Aecert-Robotics/Hexapod/PCB/Hexapod PCB KiCad Project/Components/Voltage Regulator LM2596/dc-dc-lm2596-3a-step-down-converter-module-1.snapshot.5/HW-411_Top.jpg

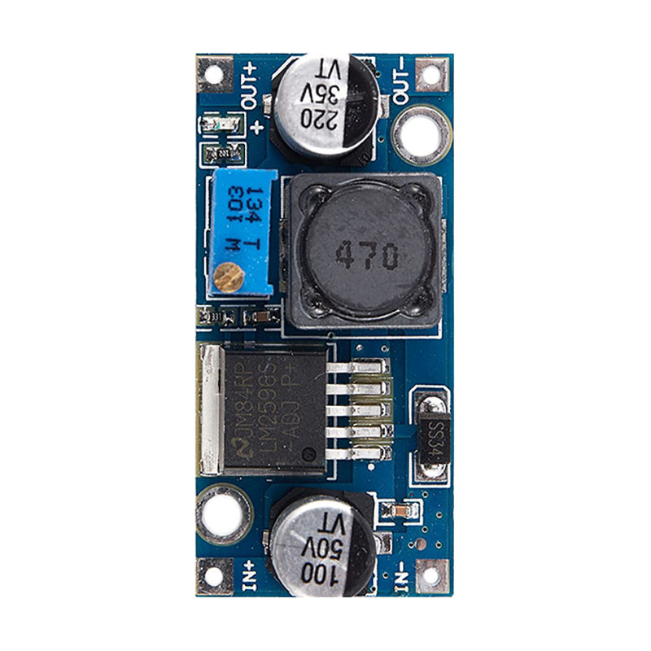
PCB/Hexapod PCB KiCad Project/Components/Voltage Regulator LM2596/dc-dc-lm2596-3a-step-down-converter-module-1.snapshot.5/HW-411_Top.jpg
