Aecert-Robotics/Hexapod/Pics/Color Scheme 5.png

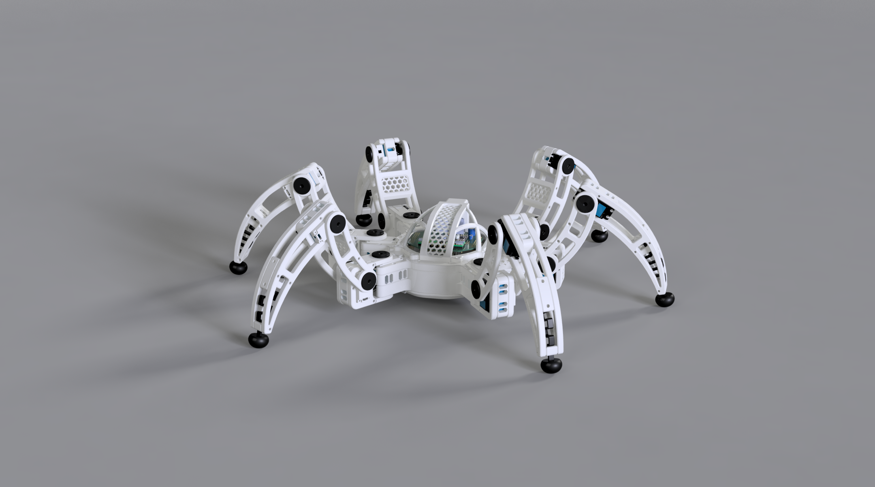
Pics/Color Scheme 5.png
