Aecert-Robotics/Hexapod/Pics/Color Scheme A.png

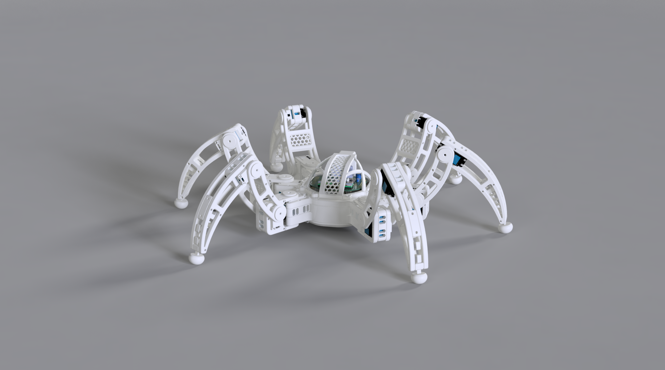
Pics/Color Scheme A.png
