Aecert-Robotics/Hexapod/PCB/Hexapod PCB KiCad Project/Components/nrf24l01/Renderings/nRF24L01+ CAD model 2.png

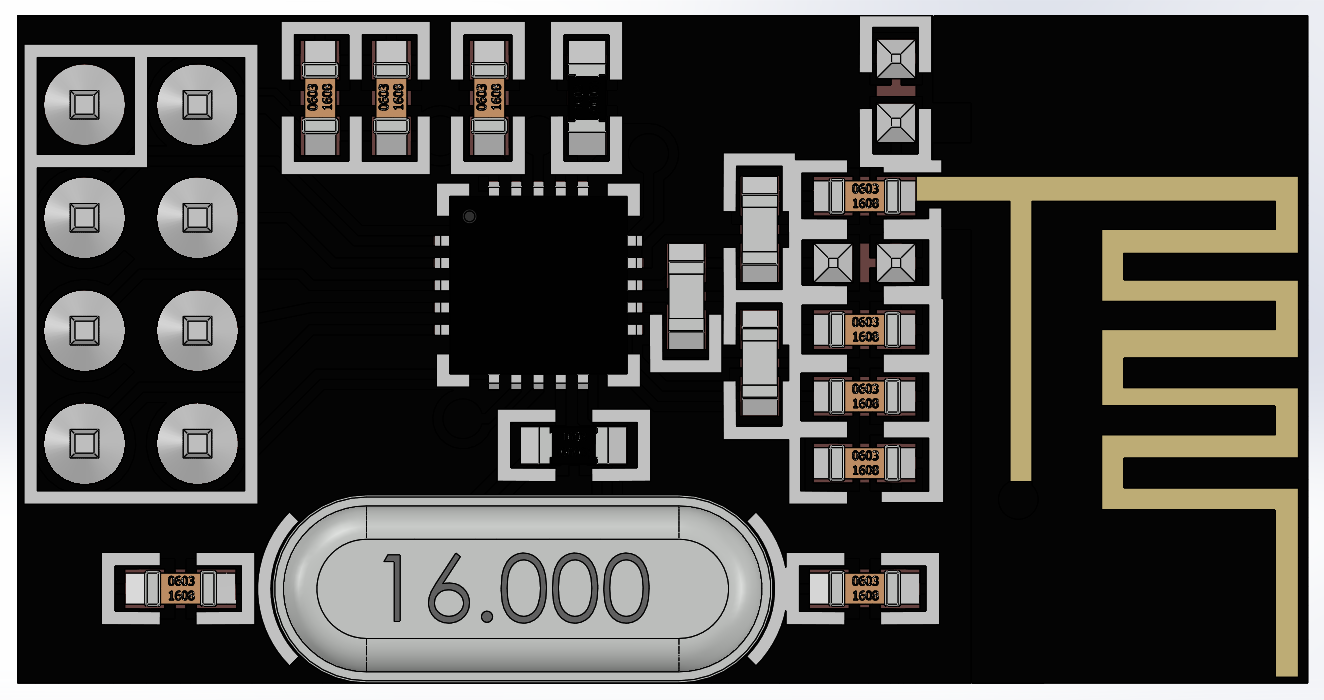
PCB/Hexapod PCB KiCad Project/Components/nrf24l01/Renderings/nRF24L01+ CAD model 2.png
