Aecert-Robotics/Hexapod/PCB/Hexapod PCB KiCad Project/Components/nrf24l01/Renderings/nRF24L01+ CAD model.png

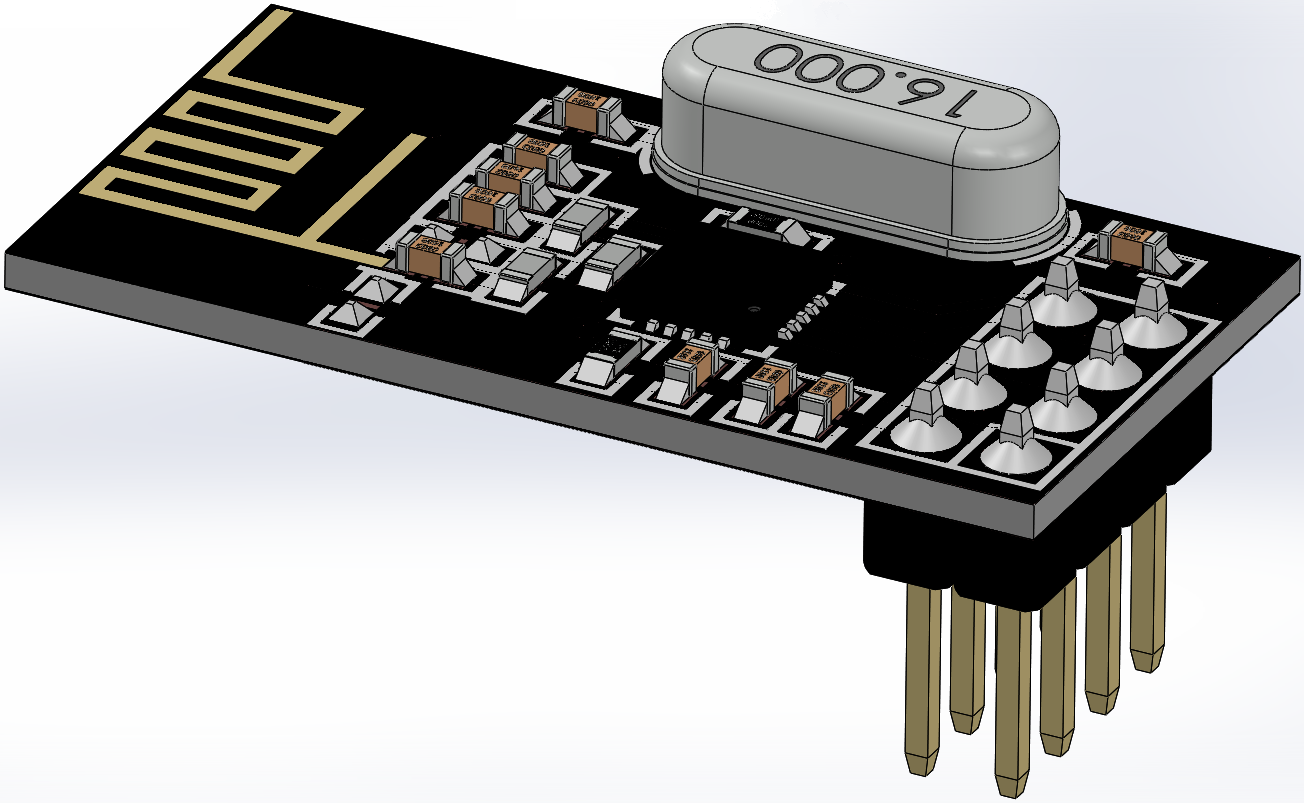
PCB/Hexapod PCB KiCad Project/Components/nrf24l01/Renderings/nRF24L01+ CAD model.png
