Aecert-Robotics/Hexapod/PCB/Hexapod PCB KiCad Project/Components/MPU6050 THT/MPU6050.stp

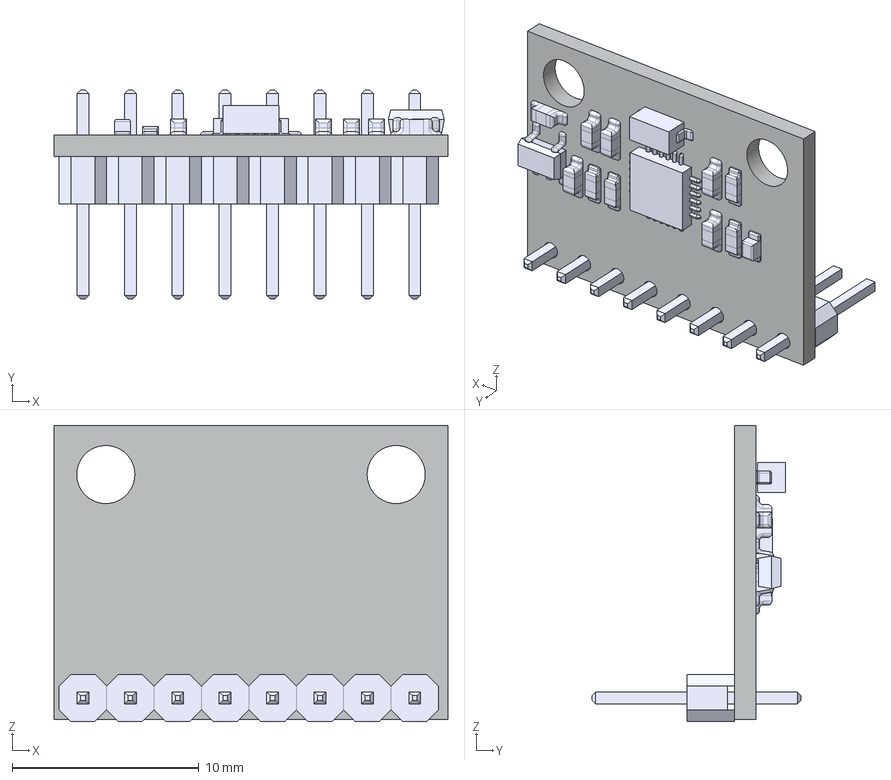
[picture p10: CAD file, 2025-02-21]
PCB/Hexapod PCB KiCad Project/Components/MPU6050 THT/MPU6050.stp
21.1 x 11.2 x 15.9 mm
