Aecert-Robotics/Hexapod/PCB/Hexapod PCB KiCad Project/Components/Terminal 2 Pin/TB005-762-02BE.step

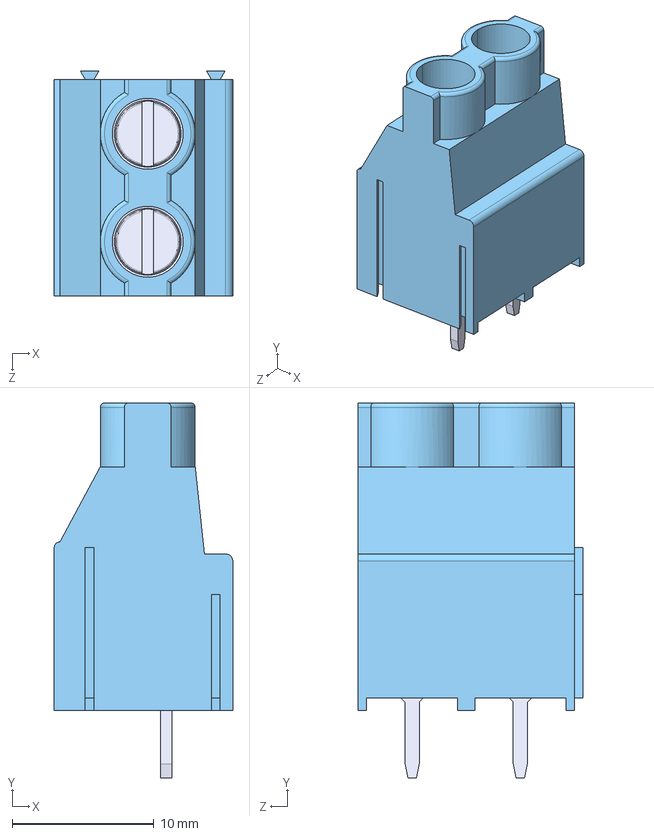
[picture p11: CAD file, 2025-02-17]
PCB/Hexapod PCB KiCad Project/Components/Terminal 2 Pin/TB005-762-02BE.step
12.6 x 26.5 x 15.8 mm
