Aecert-Robotics/Hexapod/STLs/Servo Case Blue Non Pro.stl

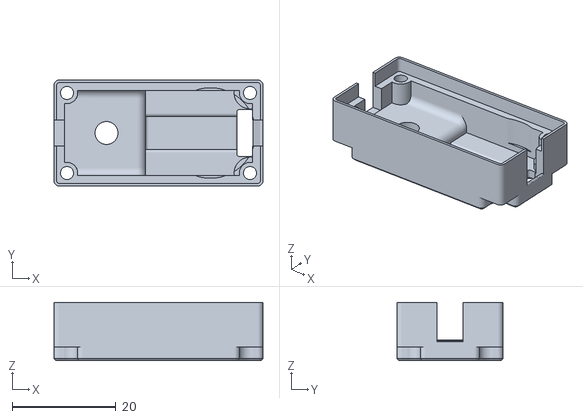
[picture p12: CAD file, 2025-04-15]
STLs/Servo Case Blue Non Pro.stl
40.2 x 20.4 x 11.2
