Aecert-Robotics/Hexapod/STLs/Everything.3mf

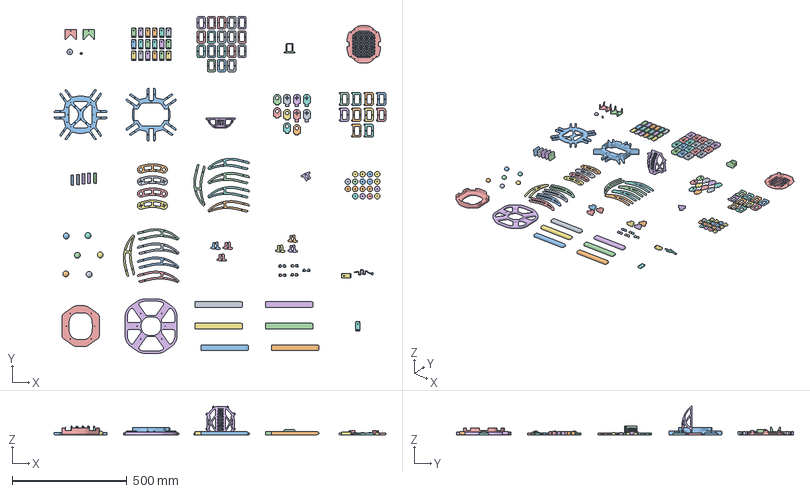
[picture p13: CAD file, 2025-04-09]
STLs/Everything.3mf
1445.1 x 1468.4 x 124.7 mm
Servo Case RED.stl x 19
Stand Leg.stl x 6
Tibia Bridge.stl x 7
Foot Shaft.stl
Tibia Left.stl x 5
Tibia Right.stl x 5
Femur Axle Side.stl x 2
Femur Bridge.stl x 5
Femur Horn Side.stl x 2
Coxa Left.stl x 5
Coxa Bottom.stl x 5
Coxa Right.stl x 5
Foot Left.stl x 5
PCB Spacer.stl
Foot Right.stl x 5
Coxa Top.stl x 5
Servo Case Axle.stl x 19
Frame Center.stl
Battery Clip.stl x 2
Servo Mount.stl x 18
Frame Top.stl
Power Switch Holder.stl
Frame Bottom.stl
Roll Cage TEST 3.stl
Foot Toe.stl x 6
Stand Top.stl
Stand Base.stl
Servo Case BLUE.stl
