Aecert-Robotics/Hexapod/STLs/Servo Case BLUE.stl

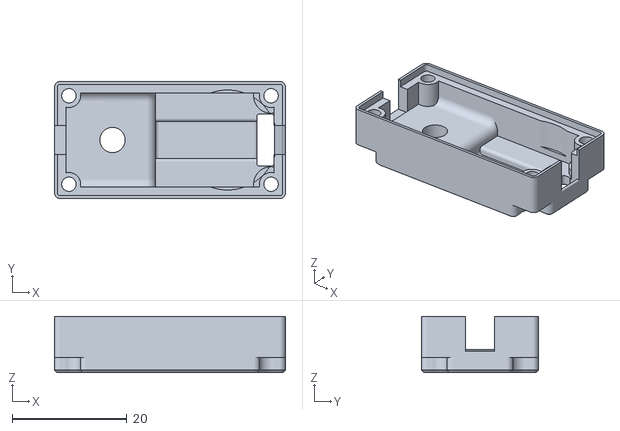
[picture p14: CAD file, 2025-04-09]
STLs/Servo Case BLUE.stl
40.2 x 20.4 x 9.75
