Aecert-Robotics/Hexapod/STLs/Battery.stl

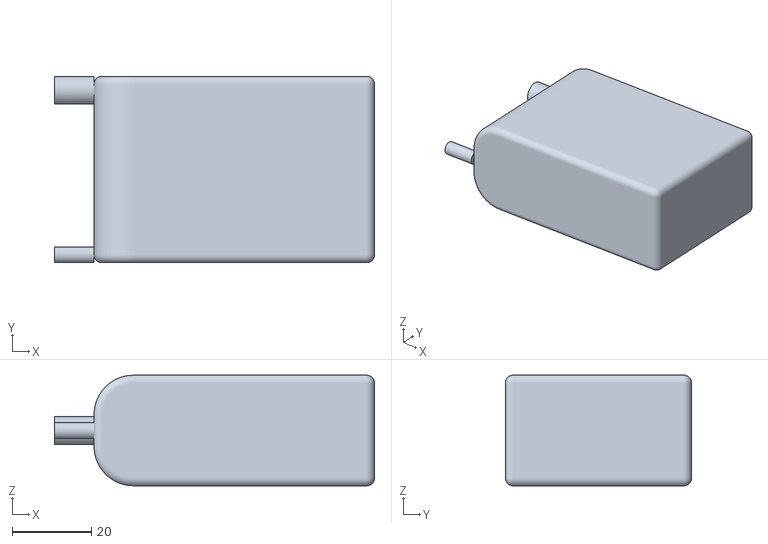
[picture p15: CAD file, 2025-03-29]
STLs/Battery.stl
81.0 x 47.2 x 28.0
