Aecert-Robotics/Hexapod/STLs/Stand Top.stl

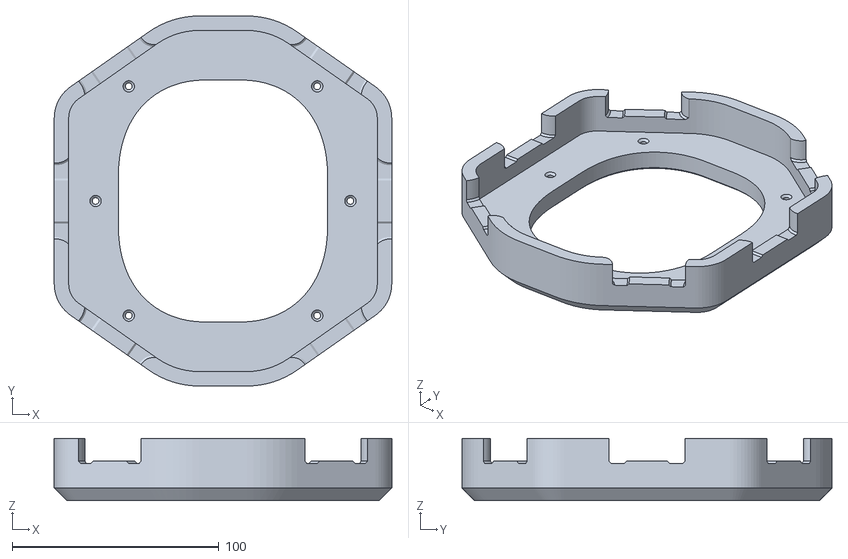
[picture p16: CAD file, 2025-03-29]
STLs/Stand Top.stl
163.3 x 179.0 x 30.0
