Aecert-Robotics/Hexapod/STLs/Stand Leg.stl

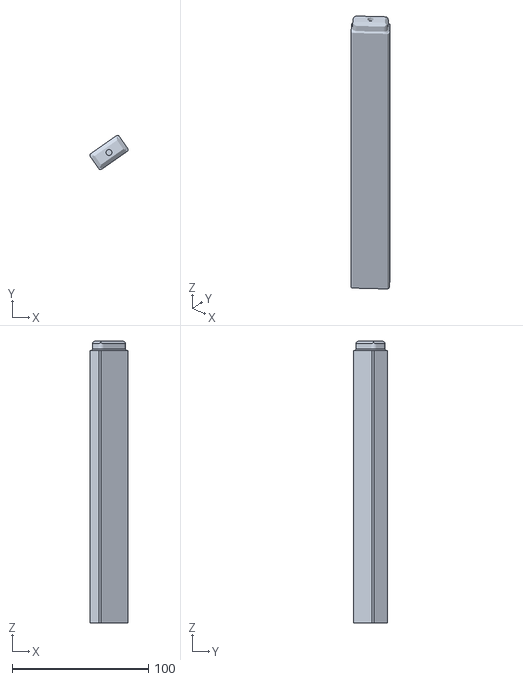
[picture p17: CAD file, 2025-03-29]
STLs/Stand Leg.stl
28.2 x 25.2 x 207.0
