Aecert-Robotics/Hexapod/STLs/Stand Base.stl

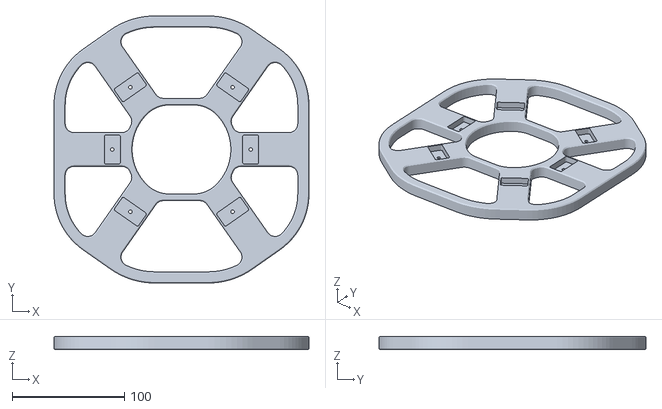
[picture p18: CAD file, 2025-03-29]
STLs/Stand Base.stl
227.3 x 238.0 x 12.0
