Aecert-Robotics/Hexapod/STLs/Coxa Bottom.stl

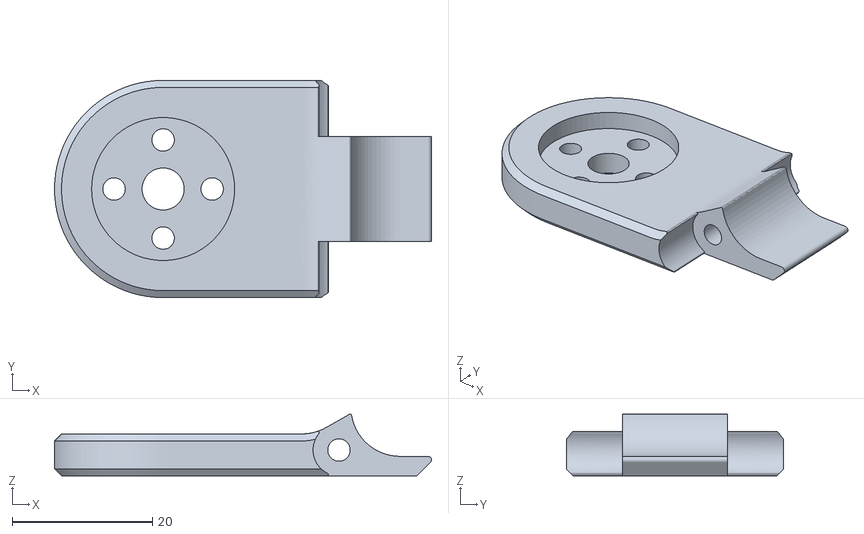
[picture p19: CAD file, 2025-03-27]
STLs/Coxa Bottom.stl
53.8 x 31.0 x 8.84
