Aecert-Robotics/Hexapod/STLs/Coxa Left.stl

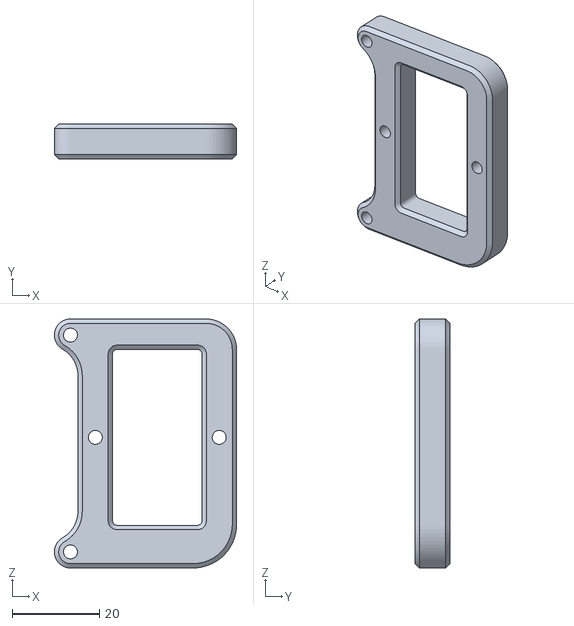
[picture p20: CAD file, 2025-03-27]
STLs/Coxa Left.stl
41.8 x 8.00 x 57.1
