Aecert-Robotics/Hexapod/STLs/Coxa Top.stl

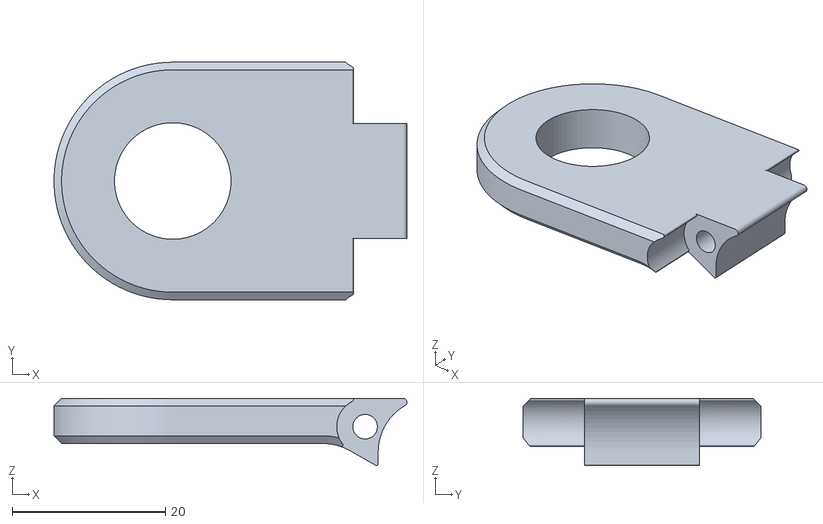
[picture p21: CAD file, 2025-03-27]
STLs/Coxa Top.stl
46.0 x 31.0 x 8.79
