Aecert-Robotics/Hexapod/STLs/Foot Shaft.stl

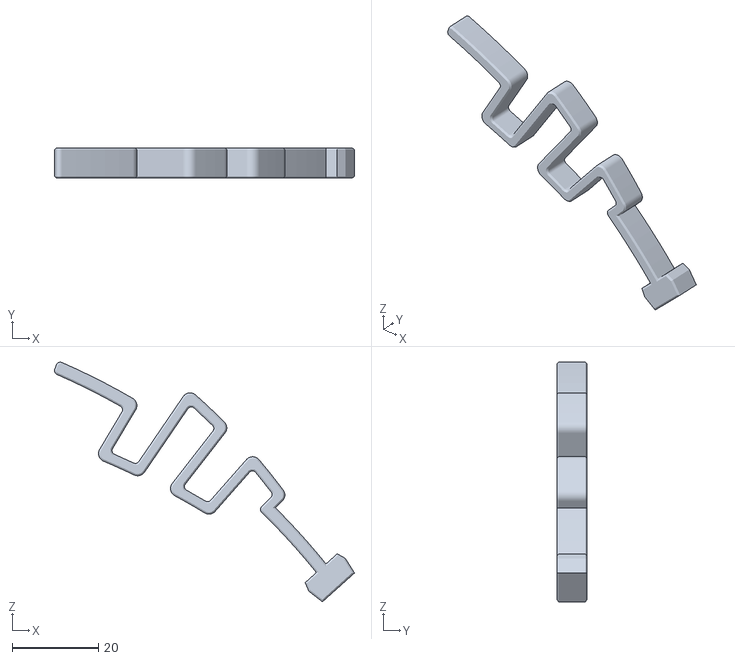
[picture p22: CAD file, 2025-03-27]
STLs/Foot Shaft.stl
69.6 x 7.00 x 55.6
