Aecert-Robotics/Hexapod/STLs/Tibia Bridge.stl

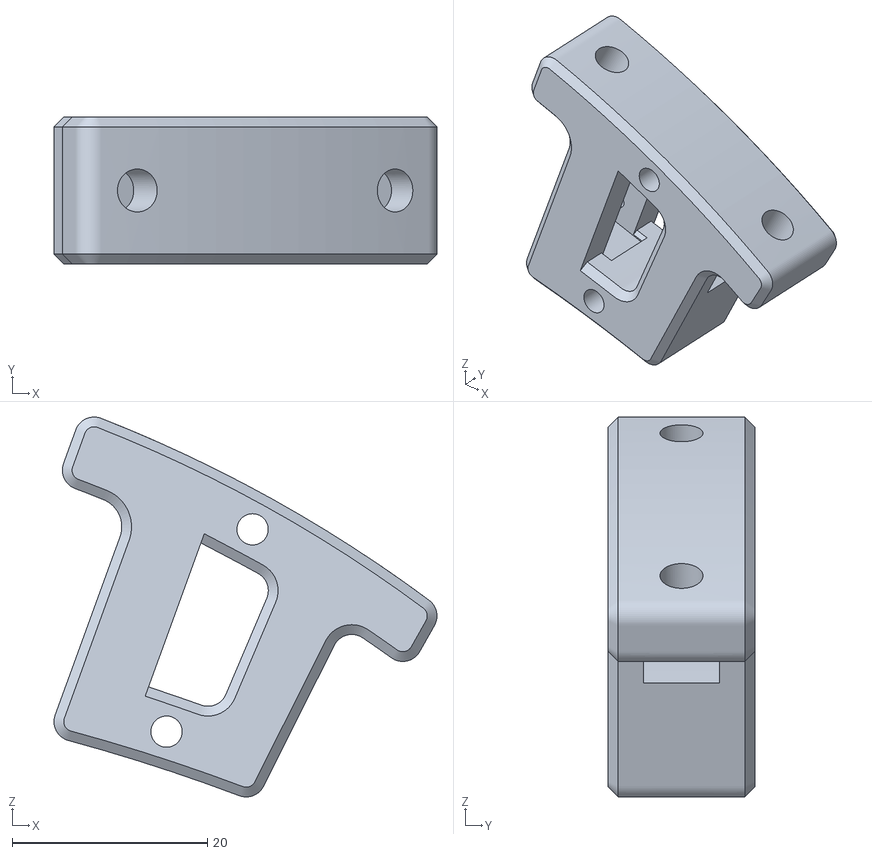
[picture p23: CAD file, 2025-03-27]
STLs/Tibia Bridge.stl
39.2 x 15.0 x 38.9
