Aecert-Robotics/Hexapod/STLs/Femur Horn Side.stl

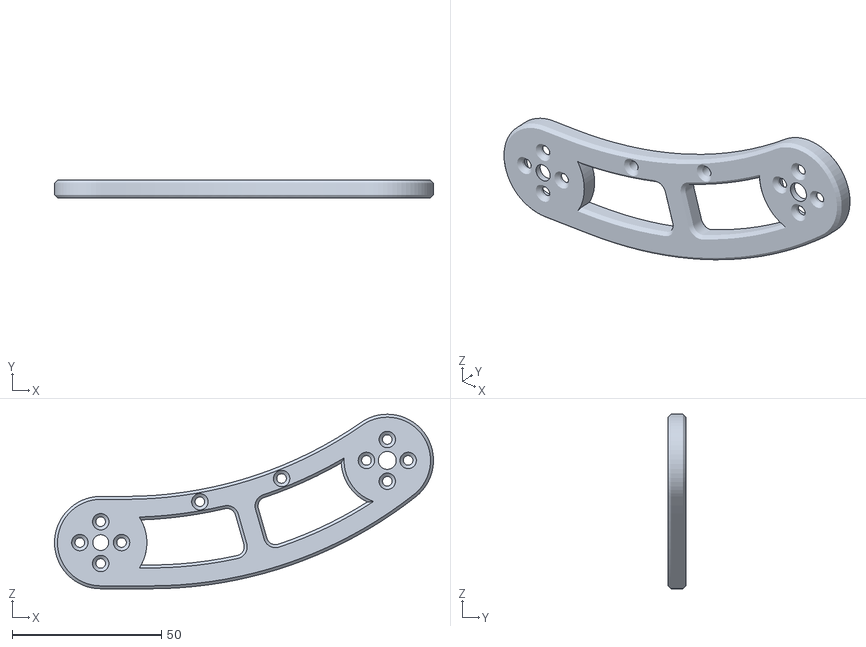
[picture p24: CAD file, 2025-03-27]
STLs/Femur Horn Side.stl
127.1 x 6.00 x 58.6
