Aecert-Robotics/Hexapod/STLs/Femur Axle Side.stl

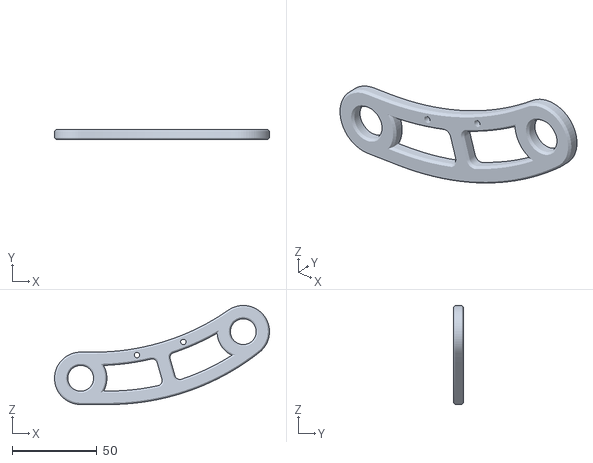
[picture p25: CAD file, 2025-03-27]
STLs/Femur Axle Side.stl
127.1 x 6.00 x 58.6
