Aecert-Robotics/Hexapod/STLs/Tibia Left.stl

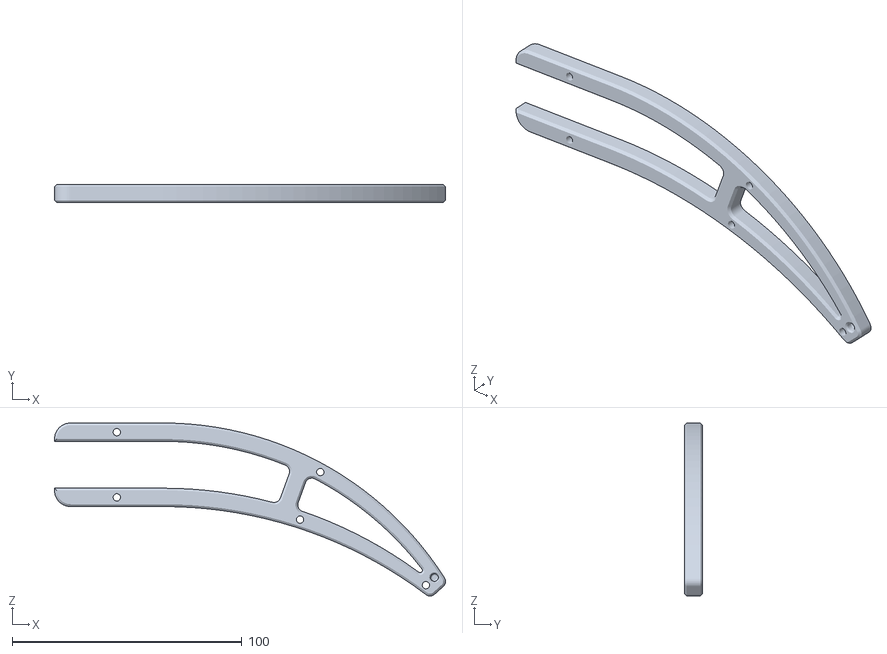
[picture p26: CAD file, 2025-03-27]
STLs/Tibia Left.stl
170.3 x 8.00 x 75.4
