Aecert-Robotics/Hexapod/STLs/Foot Right.stl

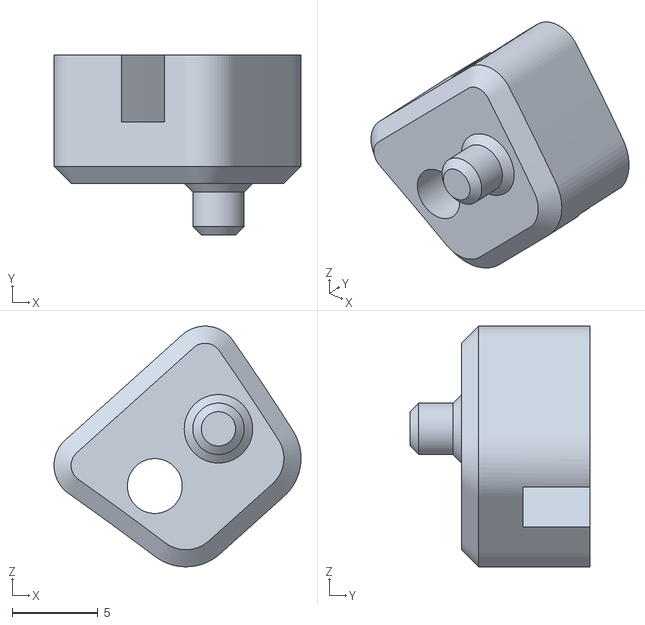
[picture p27: CAD file, 2025-03-27]
STLs/Foot Right.stl
14.4 x 10.5 x 14.1
