Aecert-Robotics/Hexapod/STLs/Femur Bridge.stl

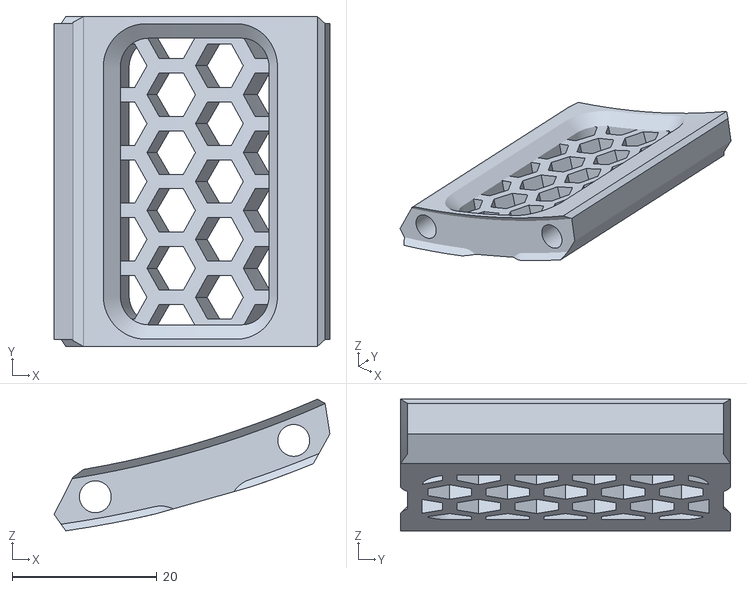
[picture p28: CAD file, 2025-03-27]
STLs/Femur Bridge.stl
38.1 x 45.6 x 18.2
