Aecert-Robotics/Hexapod/STLs/Roll Cage.stl

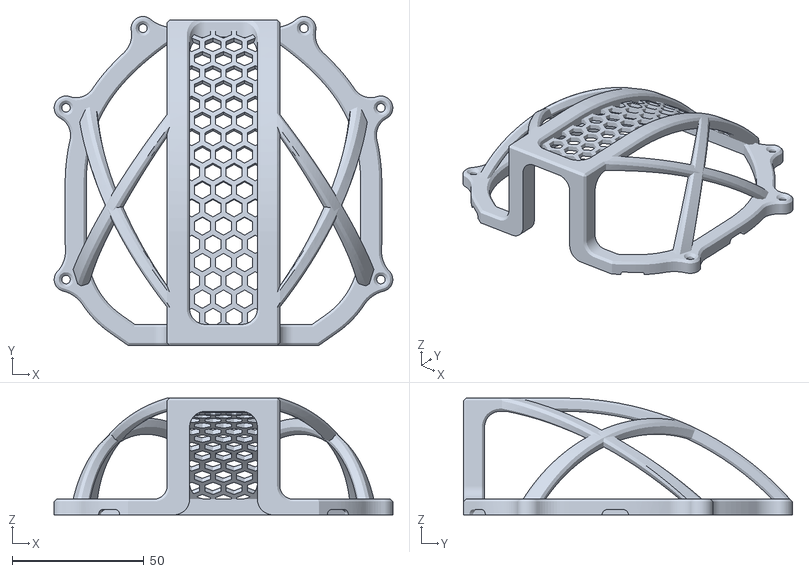
[picture p29: CAD file, 2025-03-26]
STLs/Roll Cage.stl
128.3 x 124.7 x 44.2
