Aecert-Robotics/Hexapod/STLs/Servo Case Axle.stl

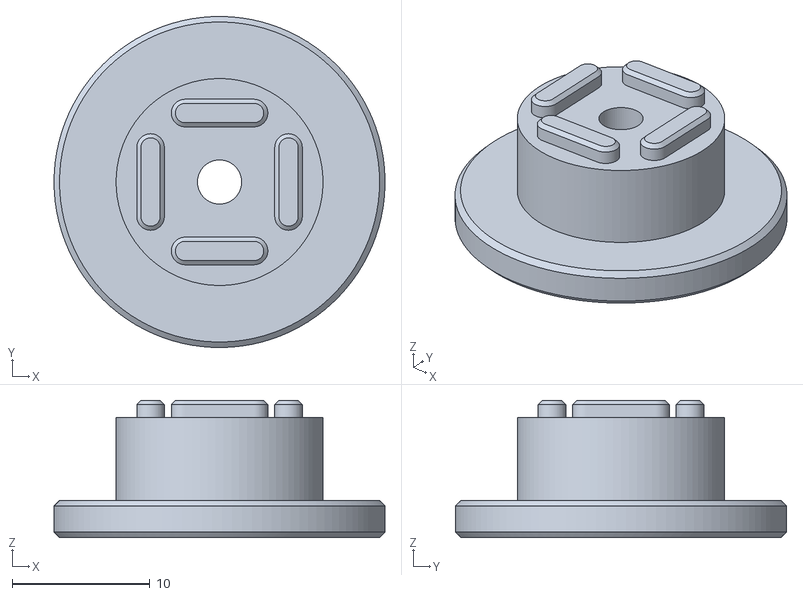
[picture p30: CAD file, 2025-03-26]
STLs/Servo Case Axle.stl
24.0 x 24.0 x 9.95
