Aecert-Robotics/Hexapod/STLs/Femur Cap.stl

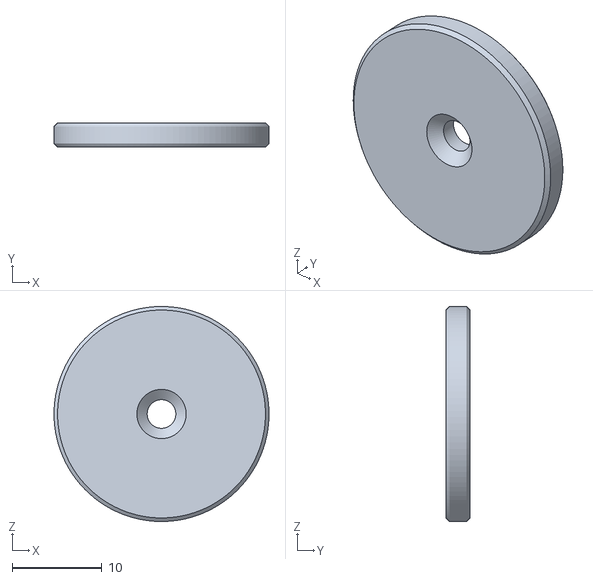
[picture p31: CAD file, 2025-03-26]
STLs/Femur Cap.stl
24.0 x 2.70 x 24.0
