Aecert-Robotics/Hexapod/STLs/Servo Mount.stl

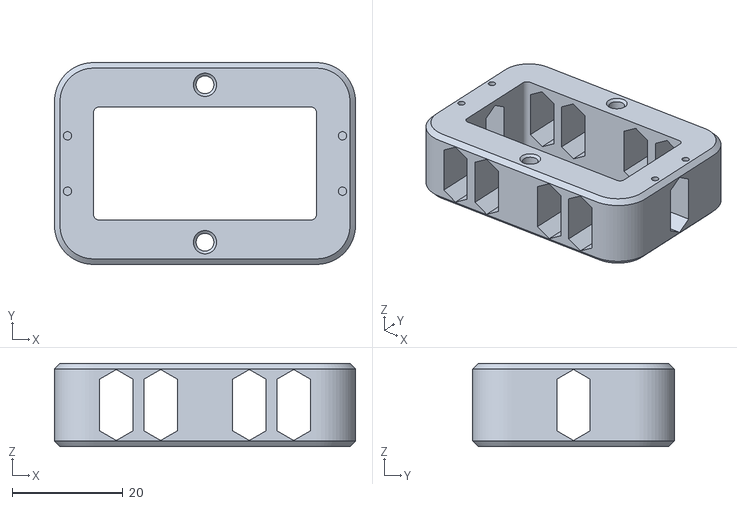
[picture p32: CAD file, 2025-03-26]
STLs/Servo Mount.stl
54.3 x 36.4 x 15.0
