Aecert-Robotics/Hexapod/STLs/Frame Center.stl

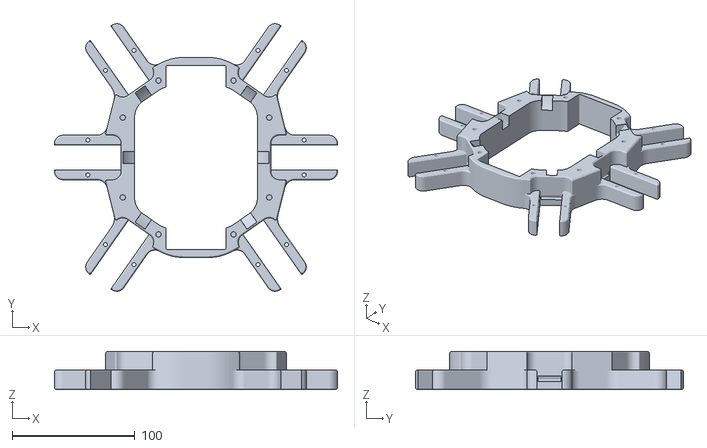
[picture p33: CAD file, 2025-03-19]
STLs/Frame Center.stl
230.6 x 218.1 x 31.0
