Aecert-Robotics/Hexapod/STLs/Battery Clip.stl

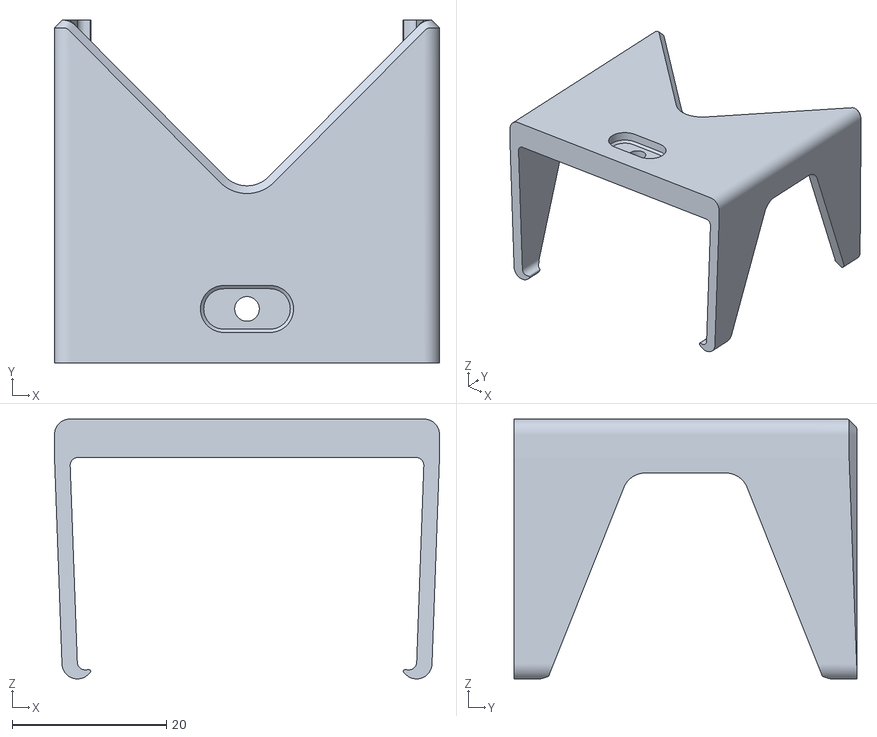
[picture p34: CAD file, 2025-03-19]
STLs/Battery Clip.stl
50.0 x 44.5 x 33.7
