Aecert-Robotics/Hexapod/STLs/Frame Bottom.stl

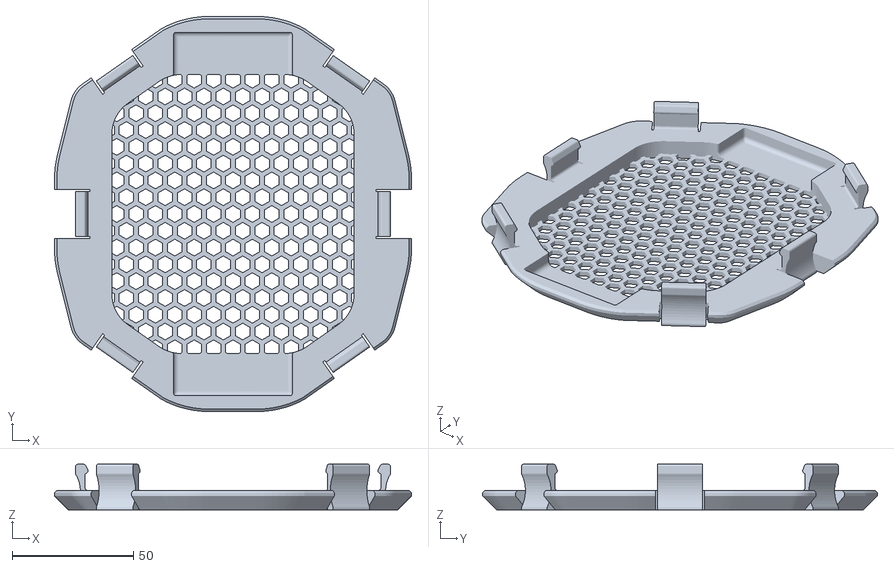
[picture p35: CAD file, 2025-03-19]
STLs/Frame Bottom.stl
147.4 x 163.0 x 18.8
