Aecert-Robotics/Hexapod/STLs/Power Switch Holder.stl

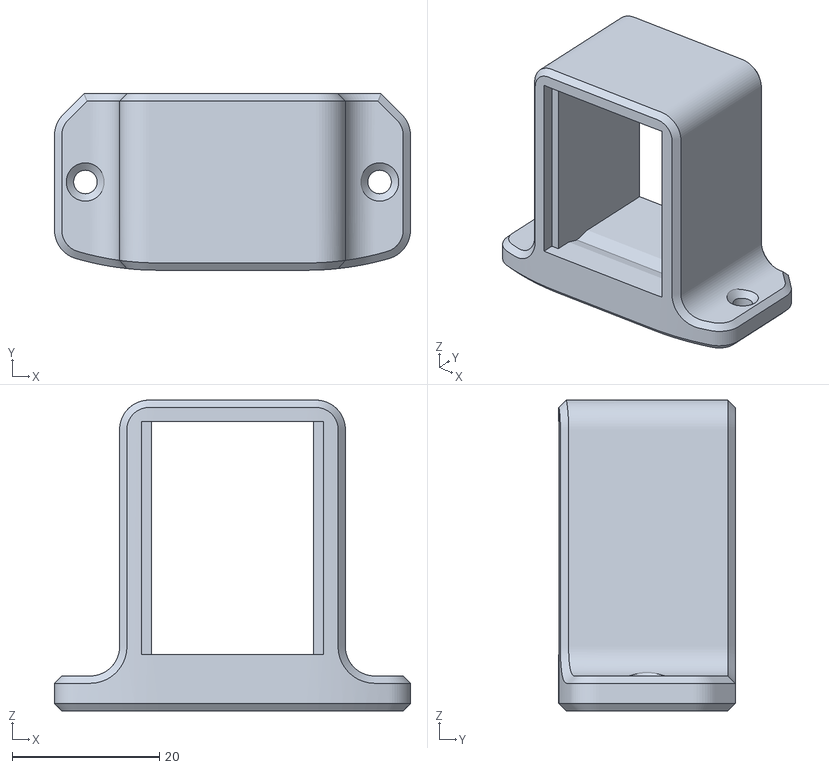
[picture p36: CAD file, 2025-03-18]
STLs/Power Switch Holder.stl
48.4 x 24.0 x 42.2
