Aecert-Robotics/Hexapod/STLs/Frame Top.stl

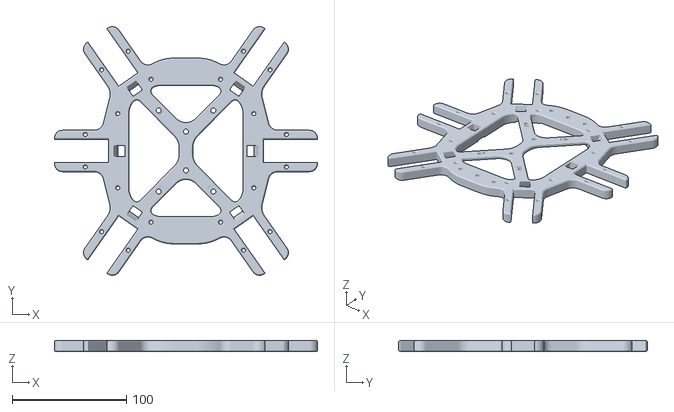
[picture p37: CAD file, 2025-03-18]
STLs/Frame Top.stl
230.6 x 218.1 x 10.0
