Aecert-Robotics/Hexapod/STLs/Foot Toe.stl

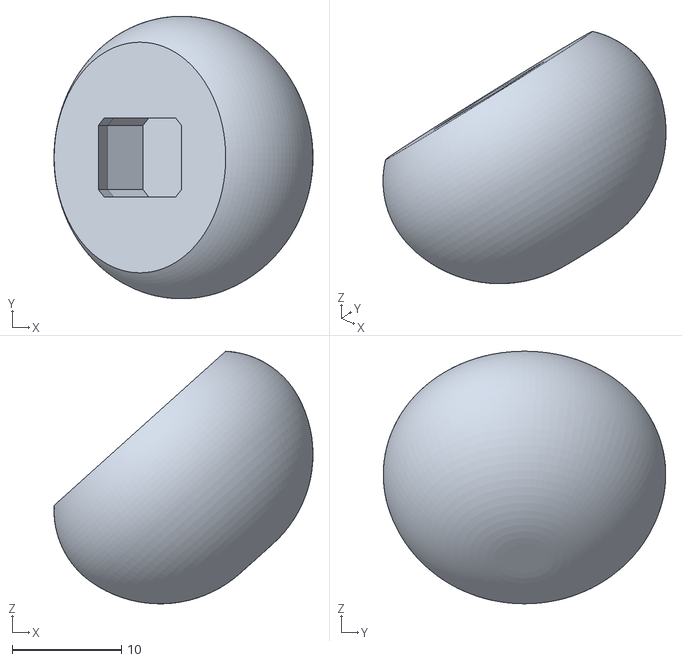
[picture p38: CAD file, 2025-03-11]
STLs/Foot Toe.stl
23.7 x 25.8 x 23.1
