Aecert-Robotics/Hexapod/STLs/Servo Case RED.stl

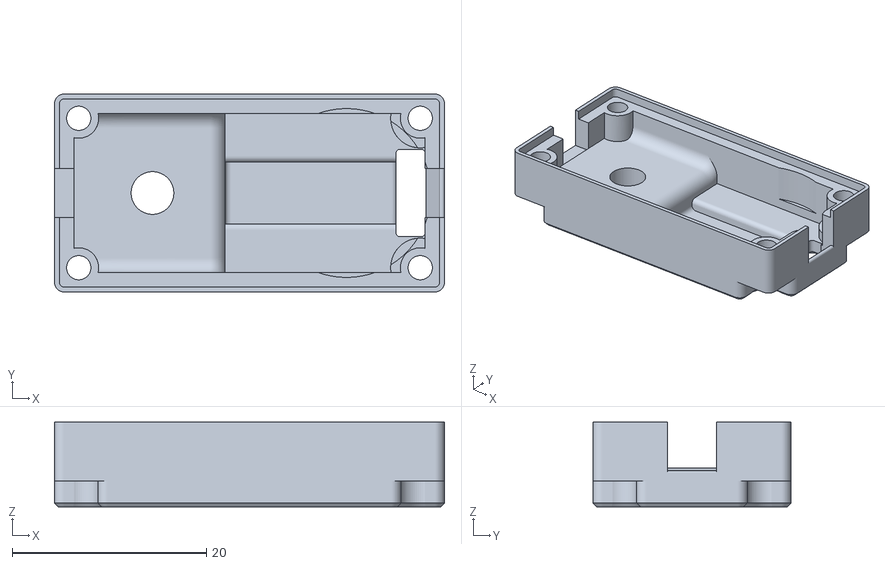
[picture p39: CAD file, 2025-03-08]
STLs/Servo Case RED.stl
40.2 x 20.4 x 8.75
