Aecert-Robotics/Hexapod/STLs/Servo Case.stl

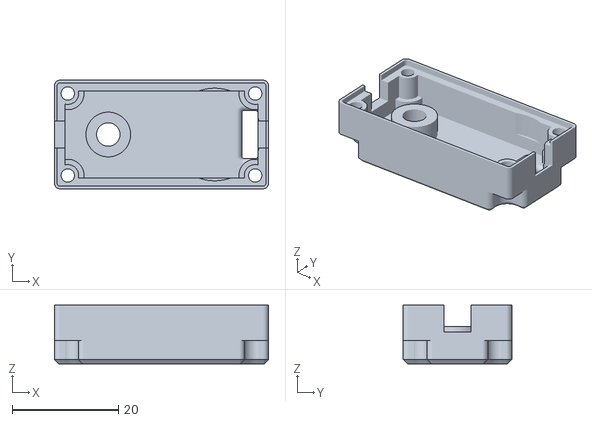
[picture p40: CAD file, 2025-03-05]
STLs/Servo Case.stl
40.2 x 20.4 x 11.0
