Aecert-Robotics/Hexapod/STLs/PCB Spacer.stl

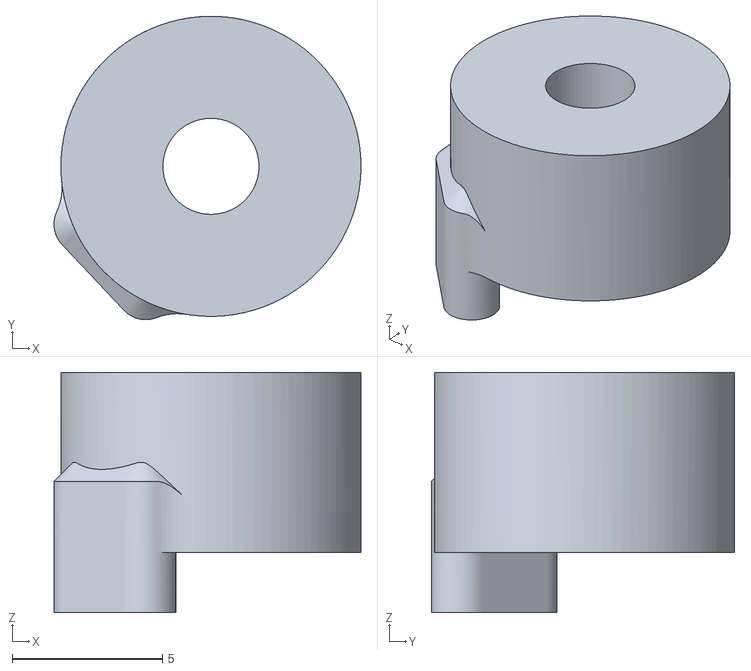
[picture p41: CAD file, 2025-03-04]
STLs/PCB Spacer.stl
10.2 x 10.1 x 8.00
