Aecert-Robotics/Hexapod/(list of files, cad)

Other CAD files:
STLs/Coxa Right.stl
STLs/Tibia Right.stl
STLs/Foot Left.stl
