Aecert-Robotics/Hexapod/Pics/Assembled (Fast).png

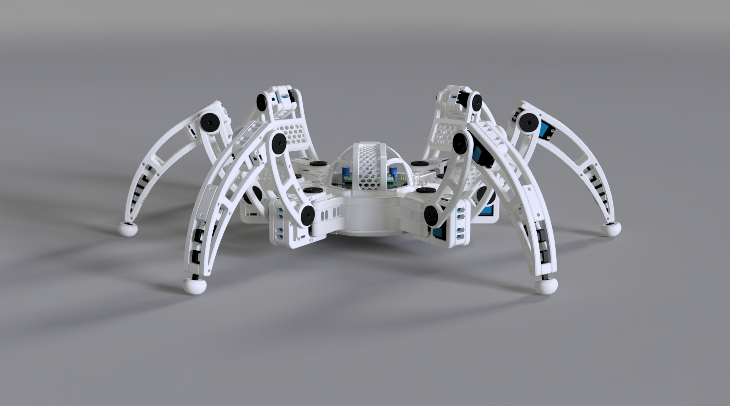
Pics/Assembled (Fast).png
