Aecert-Robotics/Hexapod/Pics/Assembled.png

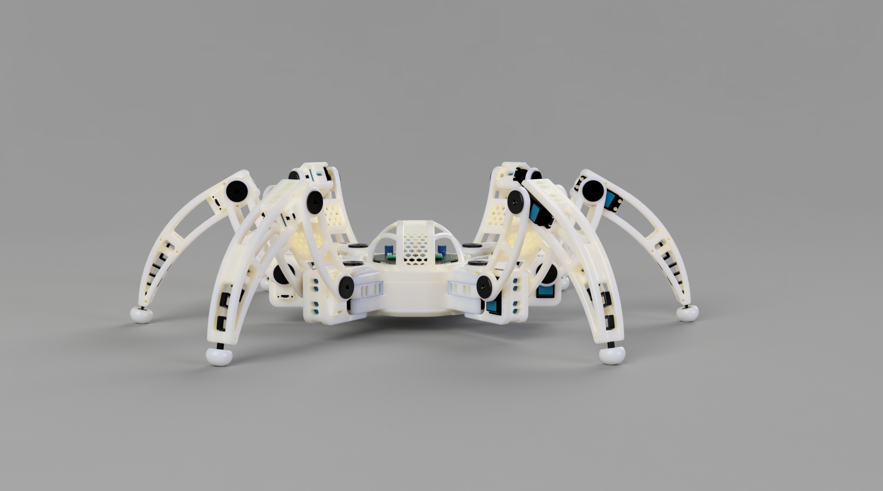
Pics/Assembled.png
