Aecert-Robotics/Hexapod/Pics/STEP.png

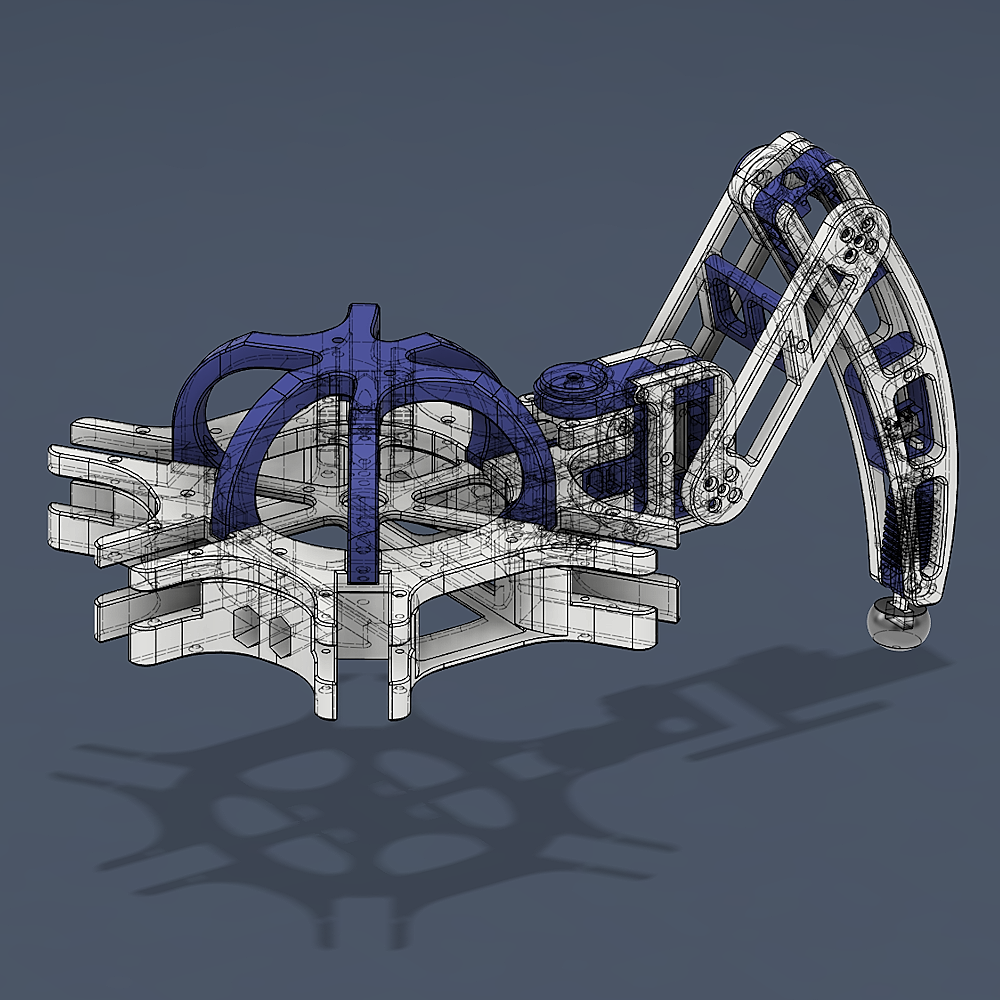
Pics/STEP.png
