Aecert-Robotics/Hexapod/PCB/Hexapod PCB KiCad Project/Hexapod PCB KiCad Project.kicad_pcb

## KiCad design PCB/Hexapod PCB KiCad Project/Hexapod PCB KiCad Project.kicad_pcb (2025-03-22)

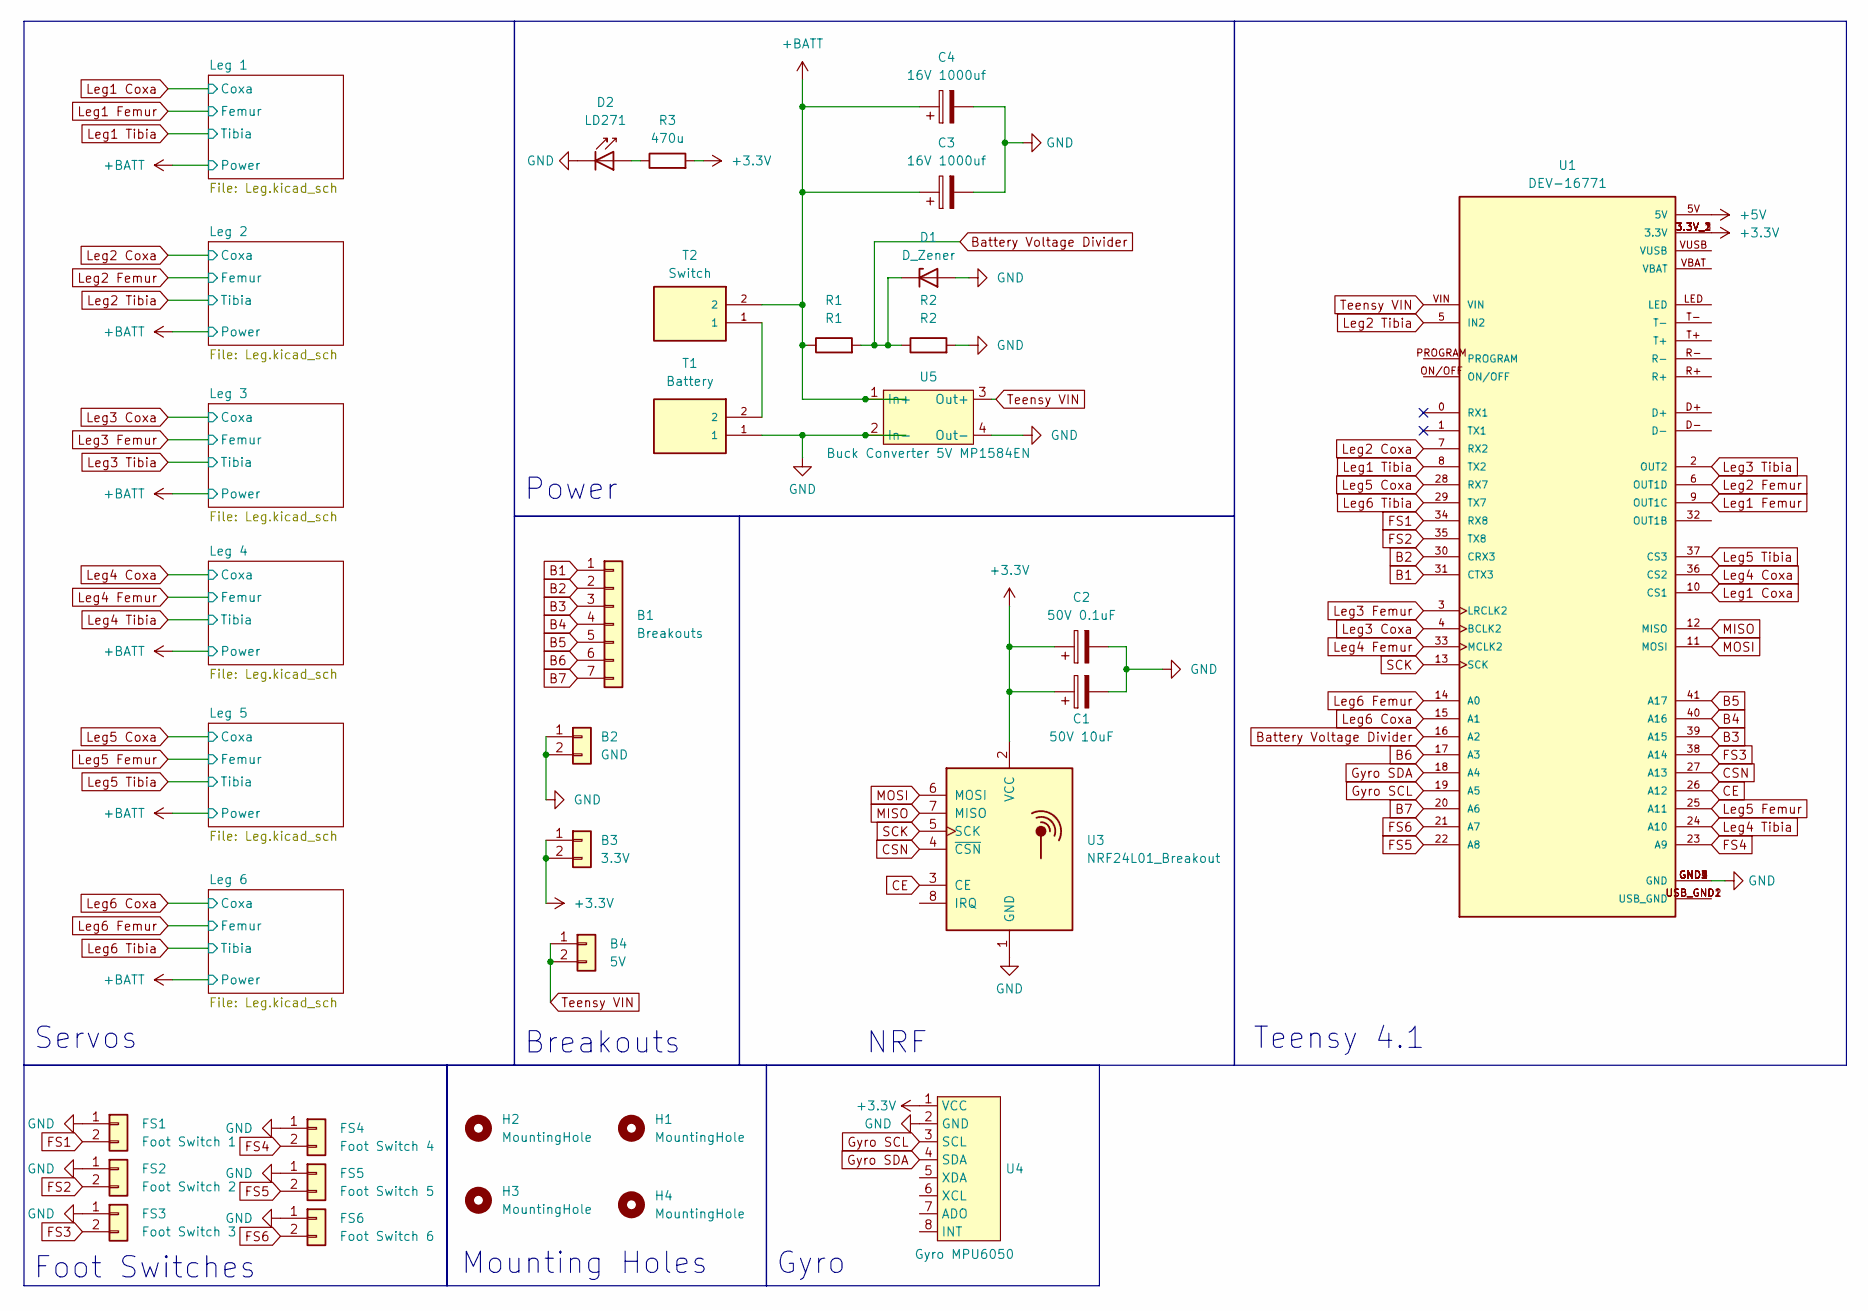
[picture p46: schematic Hexapod PCB KiCad Project.kicad_sch, Hexapod PCB - Teensy 4.1]

Parts:
B1: Breakouts; PinSocket_1x07_P2.54mm_Vertical
B2: GND; PinSocket_1x02_P2.54mm_Vertical
B3: 3.3V; PinSocket_1x02_P2.54mm_Vertical
B4: 5V; PinSocket_1x02_P2.54mm_Vertical
C1: 50V 10uF; CP_Radial_D5.0mm_P2.00mm
C2: 50V 0.1uF; CP_Radial_D4.0mm_P2.00mm
C3, C4: 16V 1000uf; CP_Radial_D10.0mm_P5.00mm
D1: D_Zener; D_T-1_P5.08mm_Horizontal
D2: LD271; LED_D5.0mm_IRGrey
FS1: Foot Switch 1; PinHeader_1x02_P2.54mm_Vertical
FS2: Foot Switch 2; PinHeader_1x02_P2.54mm_Vertical
FS3: Foot Switch 3; PinHeader_1x02_P2.54mm_Vertical
FS4: Foot Switch 4; PinHeader_1x02_P2.54mm_Vertical
FS5: Foot Switch 5; PinHeader_1x02_P2.54mm_Vertical
FS6: Foot Switch 6; PinHeader_1x02_P2.54mm_Vertical
H1, H2, H3, H4: MountingHole; MountingHole_3.2mm_M3
R1: R1; R_Axial_DIN0207_L6.3mm_D2.5mm_P7.62mm_Horizontal
R2: R2; R_Axial_DIN0207_L6.3mm_D2.5mm_P7.62mm_Horizontal
R3: 470u; R_Axial_DIN0207_L6.3mm_D2.5mm_P7.62mm_Horizontal
T1: Battery; CUI_TB005-762-02BE
T2: Switch; CUI_TB005-762-02BE
U1: DEV-16771; MODULE_DEV-16771; PARTREV 4.1
U3: NRF24L01_Breakout; nRF24L01_Breakout
U4: Gyro MPU6050; MPU6050 THT
U5: Buck Converter 5V MP1584EN

Connections:
+3.3V: B3.1, B3.2, C1.1, C2.1, R3.2, U1.3.3V_1 (3.3V), U1.3.3V_2 (3.3V), U1.3.3V_3 (3.3V), U3.2 (VCC), U4.1 (VCC)
+5V: U1.5V
+BATT: C3.1, C4.1, R1.1, T2.2, U5.1 (In+); also elsewhere on the board
B1: B1.1, U1.31 (CTX3)
B2: B1.2, U1.30 (CRX3)
B3: B1.3, U1.39 (A15)
B4: B1.4, U1.40 (A16)
B5: B1.5, U1.41 (A17)
B6: B1.6, U1.17 (A3)
B7: B1.7, U1.20 (A6)
Battery Voltage Divider: D1.1 (K), R1.2, R2.1, U1.16 (A2)
CE: U1.26 (A12), U3.3 (CE)
CSN: U1.27 (A13), U3.4 (~CSN)
FS1: FS1.2, U1.34 (RX8)
FS2: FS2.2, U1.35 (TX8)
FS3: FS3.2, U1.38 (A14)
FS4: FS4.2, U1.23 (A9)
FS5: FS5.2, U1.22 (A8)
FS6: FS6.2, U1.21 (A7)
GND: B2.1, B2.2, C1.2, C2.2, C3.2, C4.2, D1.2 (A), D2.1 (K), FS1.1, FS2.1, FS3.1, FS4.1, FS5.1, FS6.1, R2.2, T1.1, U1.GND1 (GND), U1.GND2 (GND), U1.GND3 (GND), U1.GND4 (GND), U1.GND5 (GND), U3.1 (GND), U4.2 (GND), U5.2 (In-), U5.4 (Out-); also elsewhere on the board
Gyro SCL: U1.19 (A5), U4.3 (SCL)
Gyro SDA: U1.18 (A4), U4.4 (SDA)
Leg1 Coxa: U1.10 (CS1); also elsewhere on the board
Leg1 Femur: U1.9 (OUT1C); also elsewhere on the board
Leg1 Tibia: U1.8 (TX2); also elsewhere on the board
Leg2 Coxa: U1.7 (RX2); also elsewhere on the board
Leg2 Femur: U1.6 (OUT1D); also elsewhere on the board
Leg2 Tibia: U1.5 (IN2); also elsewhere on the board
Leg3 Coxa: U1.4 (BCLK2); also elsewhere on the board
Leg3 Femur: U1.3 (LRCLK2); also elsewhere on the board
Leg3 Tibia: U1.2 (OUT2); also elsewhere on the board
Leg4 Coxa: U1.36 (CS2); also elsewhere on the board
Leg4 Femur: U1.33 (MCLK2); also elsewhere on the board
Leg4 Tibia: U1.24 (A10); also elsewhere on the board
Leg5 Coxa: U1.28 (RX7); also elsewhere on the board
Leg5 Femur: U1.25 (A11); also elsewhere on the board
Leg5 Tibia: U1.37 (CS3); also elsewhere on the board
Leg6 Coxa: U1.15 (A1); also elsewhere on the board
Leg6 Femur: U1.14 (A0); also elsewhere on the board
Leg6 Tibia: U1.29 (TX7); also elsewhere on the board
MISO: U1.12 (MISO), U3.7 (MISO)
MOSI: U1.11 (MOSI), U3.6 (MOSI)
unnamed: D2.2 (A), R3.1
unnamed: T1.2, T2.1
unnamed: U1.USB_GND1 (USB_GND), U1.USB_GND2 (USB_GND)
SCK: U1.13 (SCK), U3.5 (SCK)
Teensy VIN: B4.1, B4.2, U1.VIN, U5.3 (Out+)

Notes on the sheet:
Foot Switches
Gyro
Teensy 4.1
Servos
Power
Mounting Holes
Breakouts
NRF

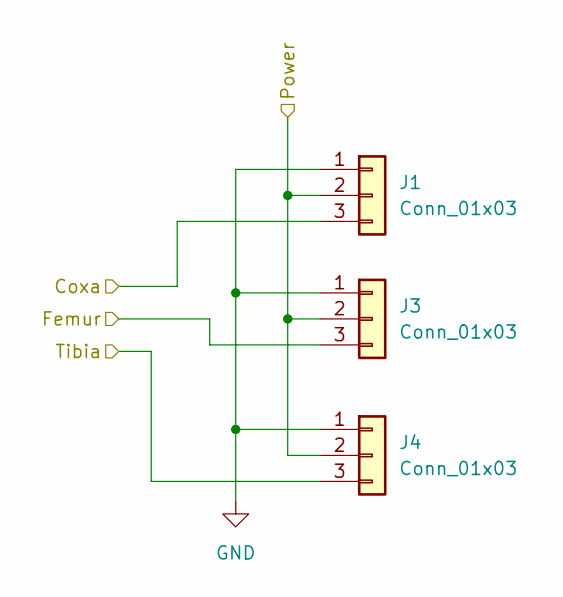
[picture p47: schematic Leg.kicad_sch]

Parts:
J1, J3, J4: Conn_01x03; PinHeader_1x03_P2.54mm_Vertical

Parts of its further copies:
Cox1, Cox2, Cox3, Cox4, Cox5, Cox6: Conn_01x03; PinHeader_1x03_P2.54mm_Vertical
Fem1, Fem2, Fem3, Fem4, Fem5, Fem6: Conn_01x03; PinHeader_1x03_P2.54mm_Vertical
Tib1, Tib2, Tib3, Tib4, Tib5, Tib6: Conn_01x03; PinHeader_1x03_P2.54mm_Vertical

Connections of its further copies:
+BATT: Cox1.2, Cox2.2, Cox3.2, Cox4.2, Cox5.2, Cox6.2, Fem1.2, Fem2.2, Fem3.2, Fem4.2, Fem5.2, Fem6.2, Tib1.2, Tib2.2, Tib3.2, Tib4.2, Tib5.2, Tib6.2; also elsewhere on the board
GND: Cox1.1, Cox2.1, Cox3.1, Cox4.1, Cox5.1, Cox6.1, Fem1.1, Fem2.1, Fem3.1, Fem4.1, Fem5.1, Fem6.1, Tib1.1, Tib2.1, Tib3.1, Tib4.1, Tib5.1, Tib6.1; also elsewhere on the board
Leg1 Coxa: Cox6.3; also elsewhere on the board
Leg1 Femur: Fem6.3; also elsewhere on the board
Leg1 Tibia: Tib6.3; also elsewhere on the board
Leg2 Coxa: Cox5.3; also elsewhere on the board
Leg2 Femur: Fem5.3; also elsewhere on the board
Leg2 Tibia: Tib5.3; also elsewhere on the board
Leg3 Coxa: Cox4.3; also elsewhere on the board
Leg3 Femur: Fem4.3; also elsewhere on the board
Leg3 Tibia: Tib4.3; also elsewhere on the board
Leg4 Coxa: Cox3.3; also elsewhere on the board
Leg4 Femur: Fem3.3; also elsewhere on the board
Leg4 Tibia: Tib3.3; also elsewhere on the board
Leg5 Coxa: Cox2.3; also elsewhere on the board
Leg5 Femur: Fem2.3; also elsewhere on the board
Leg5 Tibia: Tib2.3; also elsewhere on the board
Leg6 Coxa: Cox1.3; also elsewhere on the board
Leg6 Femur: Fem1.3; also elsewhere on the board
Leg6 Tibia: Tib1.3; also elsewhere on the board

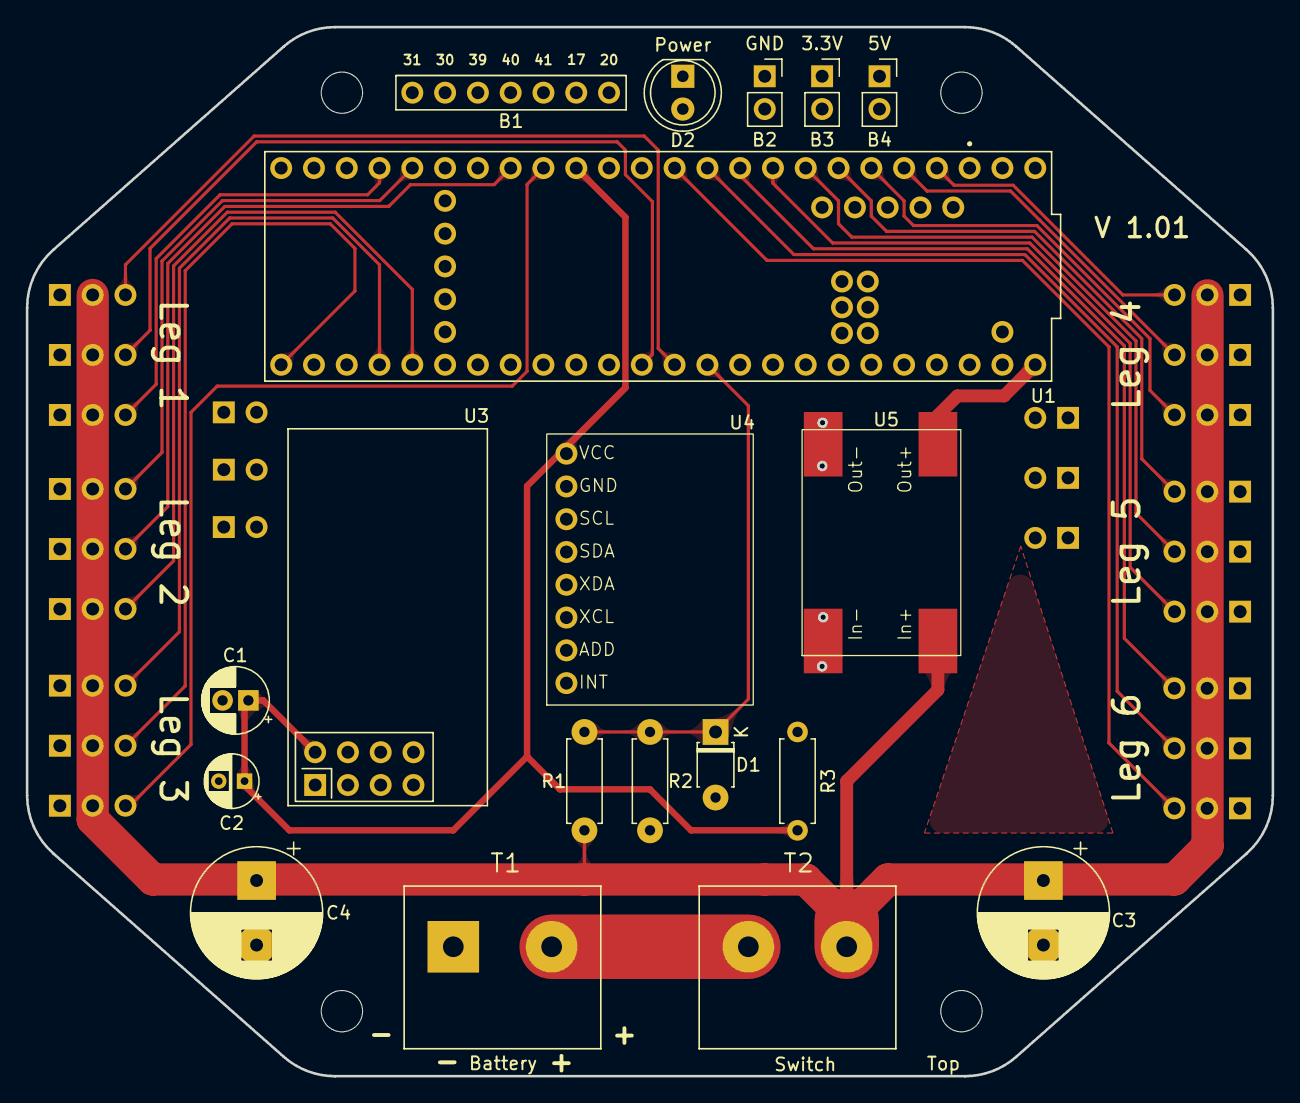
[picture p48: board Hexapod PCB KiCad Project.kicad_pcb from above]

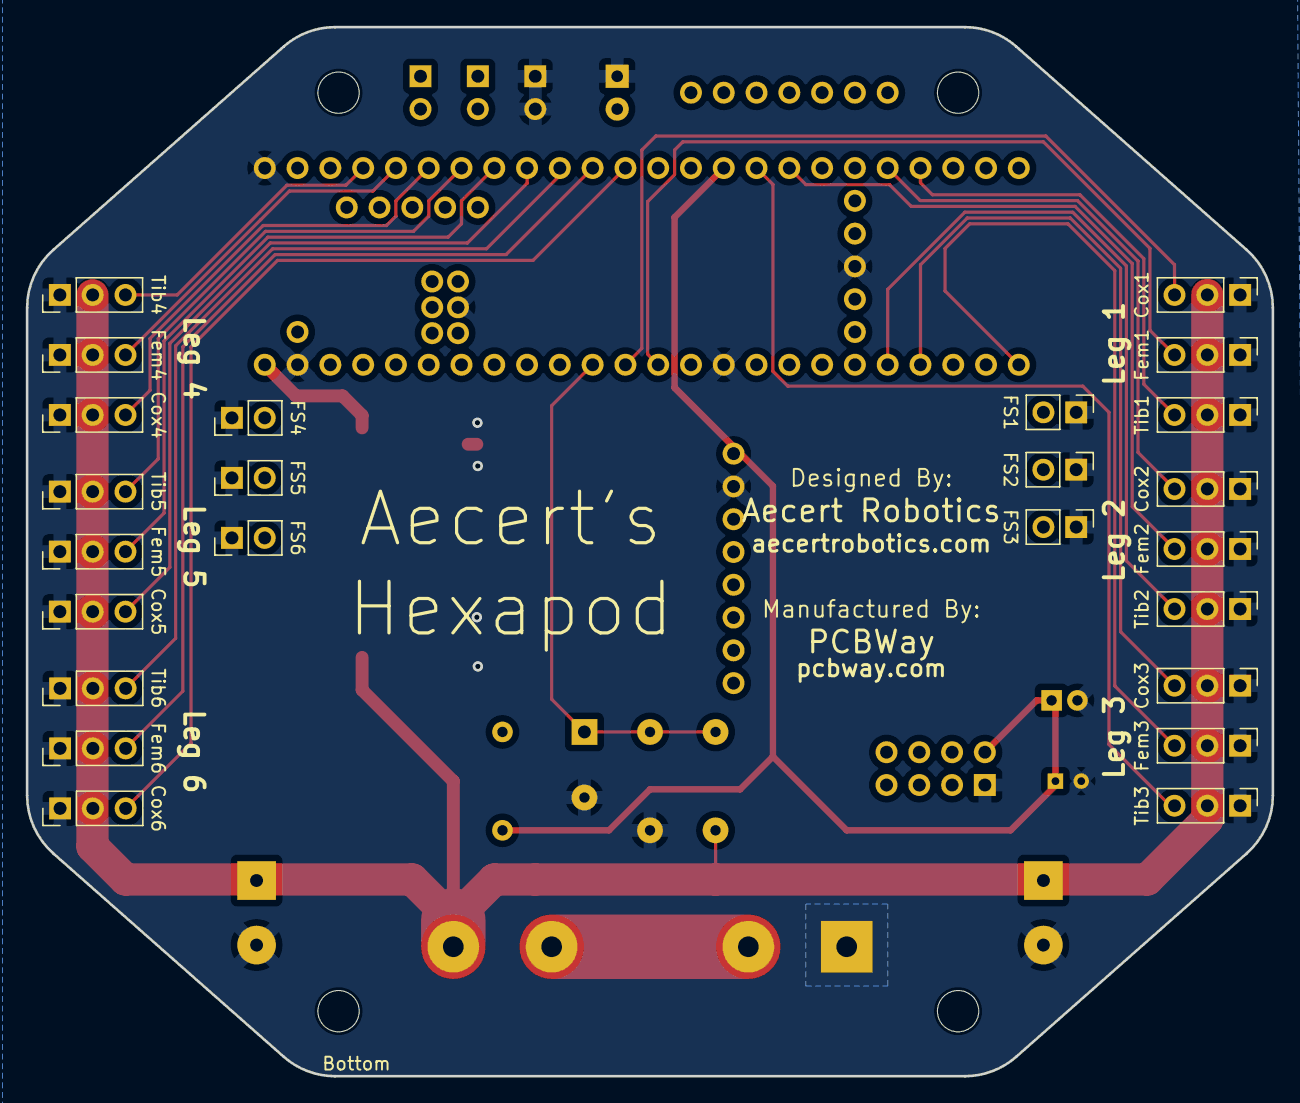
[picture p49: board Hexapod PCB KiCad Project.kicad_pcb from below]

Board: 4 copper layers, 96.5 x 81.3 mm, 47 parts (24 on the bottom side), 46 nets.
