Aecert-Robotics/Hexapod/Code/Hexapod Code/include/State.h

#pragma once

#include <Arduino.h>
#include "Utils.h"



class State
{
public:
    virtual const char* getStateName() const = 0;
    virtual void init() = 0;
    virtual void loop() = 0;
    virtual void exit() = 0;
    
};

class InitializationState : public State
{
public:
    const char* getStateName() const override { return "Initialization State"; }
    void loop() override;
    void init() override;
    void exit() override;
    
};

class CalibrationState : public State
{
public:
    const char* getStateName() const override { return "Calibration State"; }
    void loop() override;
    void init() override;
    void exit() override;
};

class SleepState : public State
{
public:
    const char* getStateName() const override { return "Sleep State"; }
    void loop() override;
    void init() override;
    void exit() override;

private:
    Vector3 target = Vector3(0, 120, -20);
    bool targetReached = false;
};

class StandingState : public State
{
public:
    const char* getStateName() const override { return "Standing State"; }
    void loop() override;
    void init() override;
    void exit() override;
    void calculateLegAdjustOrder();

private:
    int points = 1000;
};

class WalkingState : public State
{
public:
    const char* getStateName() const override { return "Walking State"; }
    void loop() override;
    void init() override;
    void exit() override;
    Vector3 getGaitPoint(int leg, float pushFraction);

private:
    int points = 1000;
    Vector2 joy1TargetVector;
    float joy1TargetMagnitude;

    Vector2 joy1CurrentVector;
    float joy1CurrentMagnitude;

    Vector2 joy2TargetVector;
    float joy2TargetMagnitude;

    Vector2 joy2CurrentVector;
    float joy2CurrentMagnitude;
};

class GyroState : public State
{
public:
    const char* getStateName() const override { return "Gyro State"; }
    void loop() override;
    void init() override;
    void exit() override;

private:
    Vector2 joy1TargetVector;
    Vector2 joy1CurrentVector;

    Vector2 joy2TargetVector;
    Vector2 joy2CurrentVector;

    Vector2 gyroTargetVector;
    Vector2 gyroCurrentVector;

    Vector3 basePoints[6];
};

class GyroStateFixed : public State
{
public:
    const char* getStateName() const override { return "Gyro State Fixed"; }
    void loop() override;
    void init() override;
    void exit() override;

private:
    Vector2 joy1TargetVector;
    Vector2 joy1CurrentVector;

    Vector2 joy2TargetVector;
    Vector2 joy2CurrentVector;

    Vector2 gyroTargetVector;
    Vector2 gyroCurrentVector;

    Vector3 basePoints[6];
};


extern State *currentState;
extern State *previousState;

extern InitializationState *initializationState;
extern CalibrationState *calibrationState;
extern SleepState *sleepState;
extern StandingState *standingState;
extern WalkingState *walkingState;
extern GyroState *gyroState;
extern GyroStateFixed *gyroStateFixed;
