Aecert-Robotics/Hexapod/(commit log)

2025-02-16 created kicad project, imported teensy 4.1 symbol, footprint, and 3d model.
    [Hexapod PCB KiCad Project.kicad_pcb, Hexapod PCB KiCad Project.kicad_sch]
2025-02-17 pcb updates
    [DS1021-1_3SF1-1.STEP, Hexapod PCB KiCad Project.kicad_pcb, Hexapod PCB KiCad Project.kicad_sch, TB005-762-02BE.step]
2025-02-21 pcb 3d models
    [Hexapod PCB KiCad Project.kicad_pcb, MPU6050.stp]
2025-02-21 sheet data
    [Hexapod PCB KiCad Project.kicad_sch]
2025-02-23 breakout updates
    [Hexapod PCB KiCad Project.kicad_pcb, Hexapod PCB KiCad Project.kicad_sch]
2025-03-02 PCB V1 Finished
    [Hexapod PCB KiCad Project-B_Mask.gbr, Hexapod PCB KiCad Project-B_Paste.gbr, Hexapod PCB KiCad Project-B_Silkscreen.gbr, Hexapod PCB KiCad Project-Edge_Cuts.gbr, Hexapod PCB KiCad Project-F_Cu.gbr, Hexapod PCB KiCad Project-F_Mask.gbr, Hexapod PCB KiCad Project-F_Paste.gbr, Hexapod PCB KiCad Project-F_Silkscreen.gbr]
2025-03-03 battery clip & screen spacers
    [Battery Clip TEST.stl, Frame Bottom TEST.stl, Frame Top TEST.stl, Spacer TEST A.stl, Spacer TEST B.stl]
2025-03-04 chamfers and holes
    [Battery Clip.stl, Frame Bottom.stl, Frame Top.stl, PCB Spacer.stl]
2025-03-04 increased height for 40mm screw
    [Frame Bottom.stl, Frame Top.stl]
2025-03-05 stl updates
    [Frame Bottom.stl, Frame Top.stl, Servo Case Axle.stl, Servo Case.stl, Servo Mount.stl]
2025-03-05 power switch holder
    [Power Switch Holder.stl]
2025-03-11 spring and foot stuff
    [Femur Bridge.stl, Foot Left.stl, Foot Right.stl, Foot Shaft 2.5mm Spring.stl, Foot Shaft 2mm Spring.stl, Foot Shaft 3.5mm Spring.stl, Foot Shaft 3mm Spring.stl, Foot Shaft.stl]
2025-03-18 fixed power switch
    [Power Switch Holder.stl]
2025-03-19 Battery Clip update + Frame bottom
    [Battery Clip.stl, Frame Bottom.stl, Frame Center.stl]
2025-03-22 pcb v1.01
    [Everything.3mf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]
2025-03-26 updated stls
    [Femur Axle Side.stl, Femur Bridge.stl, Femur Cap.stl, Femur Horn Side.stl, Foot Shaft.stl, Roll Cage.stl, Servo Case Axle.stl, Servo Mount.stl]
2025-03-26 assembled pics
2025-03-26 pcb fixes
2025-03-26 foot shaft length fix
    [Foot Shaft.stl]
2025-03-27 smaller leg
    [Coxa Bottom.stl, Coxa Left.stl, Coxa Right.stl, Coxa Top.stl, Everything.3mf, Femur Axle Side.stl, Femur Bridge.stl, Femur Horn Side.stl]
2025-03-29 pcb tests
2025-04-05 Calibration state working
2025-04-06 Added an "exit" function
    Added an "exit" function that runs after a state is exited, but before the new states "init" function runs.
    currently its only used to run the save calibration offsets function once the calibration state is exited.
2025-04-09 servo cases
    [Everything.3mf, Servo Case BLUE.stl]
2025-04-09 Added assemebly stl
2025-04-15 Create Servo Case Blue Non Pro.stl
    [Servo Case Blue Non Pro.stl]
2025-04-21 Standing state now adjusts one leg at a time
    The 3 legs at a time method that was previously used only worked properly 100% of the time with Tri gait. 1 leg at a time works with every gait.
2025-04-21 gyro state
